vintlabs/ESP32-Zip/README.md

# ESP32-Zip
## ESP32 Development kit with the same form factor (and similar pinout!) to the Raspberry Pi Zero / Zero Wireless
Note: This is not intended to be used with Pi Hats directly, however it is possible that many will work. If you want to try with a Pi Hat, please check the pinouts very carefully!

### Board top:
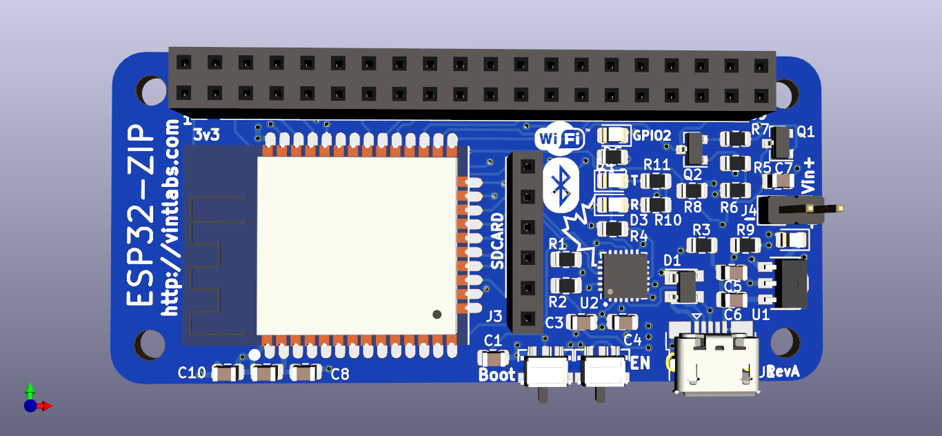
[picture p1: top.png]
Board Top

### Board bottom:
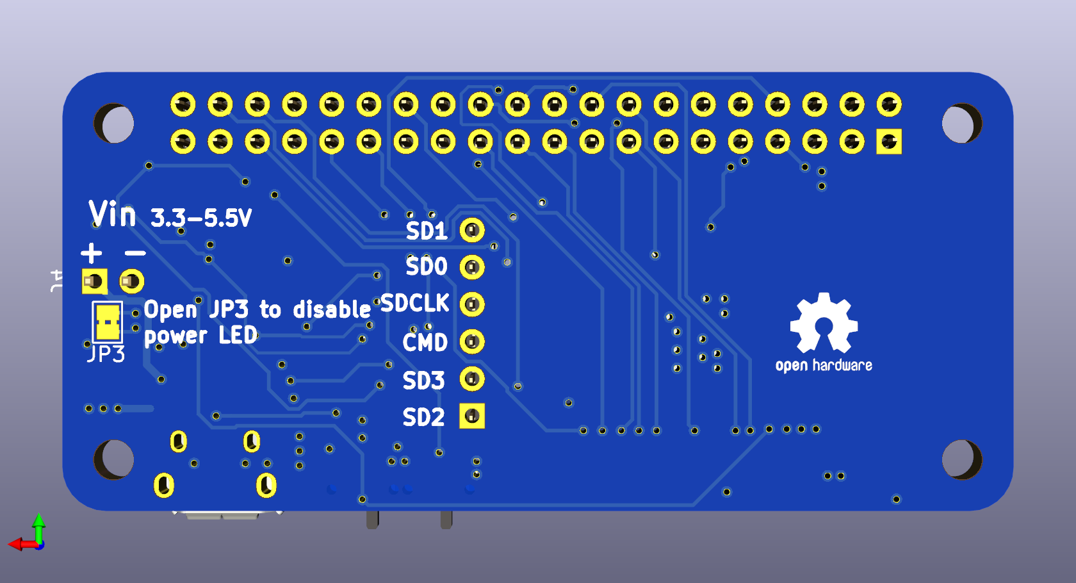
[picture p2: bottom.png]
Board Bottom

### Pinout Diagram:
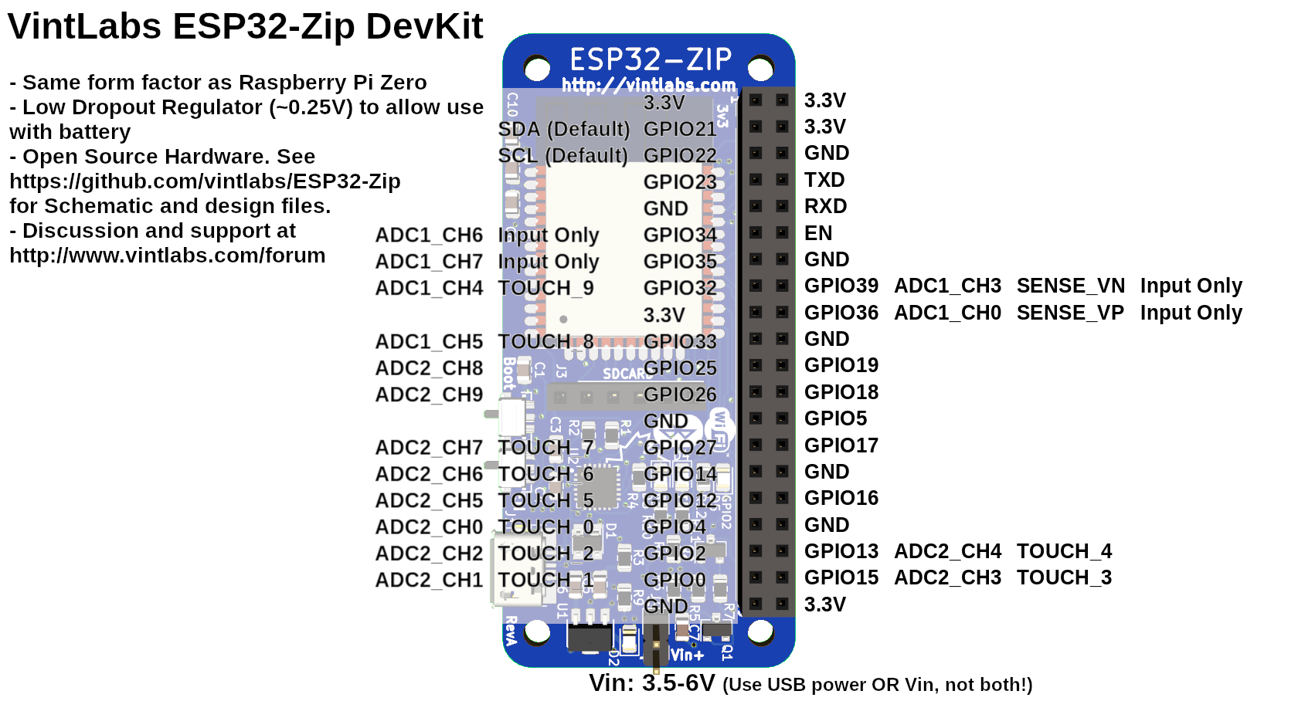
[picture p3: Pinout.png]
Pinout


### The real board:
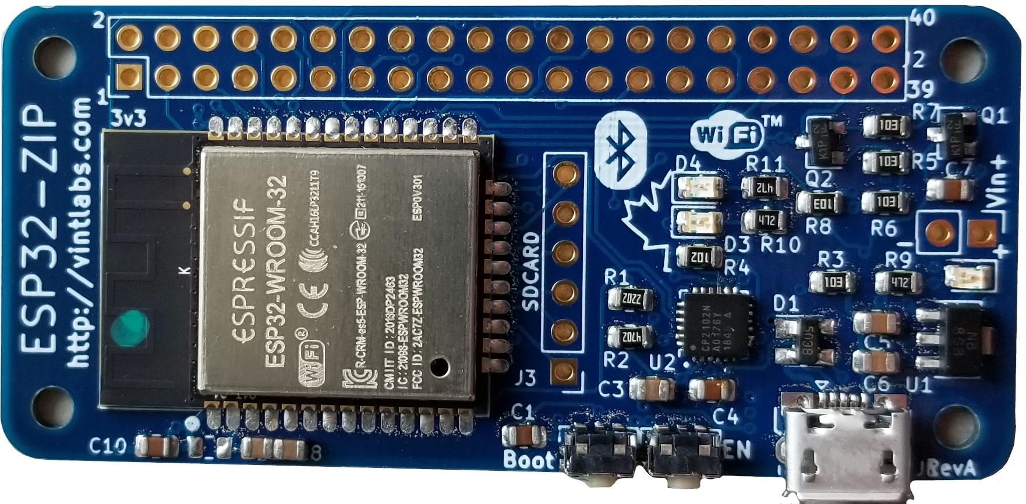
[picture p4: main_image_horizontal.png]
Top
