vintlabs/ESP32-Zip/Pinout.ods

 |  |  | Pin | Pin
 |  | VDD | 1 | 2 | VDD
 | SDA (Default) | GPIO21 | 3 | 4 | VDD
 | SCL (Default) | GPIO22 | 5 | 6 | GND
 |  | GPIO23 | 7 | 8 | TXD
 |  | GND | 9 | 10 | RXD
ADC1_CH6 | Input Only | GPIO34 | 11 | 12 | EN
ADC1_CH7 | Input Only | GPIO35 | 13 | 14 | GND
ADC1_CH4 | TOUCH_9 | GPIO32 | 15 | 16 | GPIO39 | ADC1_CH3 | SENSE_VN | Input Only
 |  | VDD | 17 | 18 | GPIO36 | ADC1_CH0 | SENSE_VP | Input Only
ADC1_CH5 | TOUCH_8 | GPIO33 | 19 | 20 | GND
ADC2_CH8 |  | GPIO25 | 21 | 22 | GPIO19
ADC2_CH9 |  | GPIO26 | 23 | 24 | GPIO18
 |  | GND | 25 | 26 | GPIO5
ADC2_CH7 | TOUCH_7 | GPIO27 | 27 | 28 | GPIO17
ADC2_CH6 | TOUCH_6 | GPIO14 | 29 | 30 | GND
ADC2_CH5 | TOUCH_5 | GPIO12 | 31 | 32 | GPIO16
ADC2_CH0 | TOUCH_0 | GPIO4 | 33 | 34 | GND
ADC2_CH2 | TOUCH_2 | GPIO2 | 35 | 36 | GPIO13 | ADC2_CH4 | TOUCH_4
ADC2_CH1 | TOUCH_1 | GPIO0 | 37 | 38 | GPIO15 | ADC2_CH3 | TOUCH_3
 |  | GND | 39 | 40 | VDD
