vintlabs/ESP32-Zip/ESP32-Zip-BOM.ods

Reference | Quantity | Value | Footprint | Datasheet
C1 C10 C4 C7 | 4 | 0.1u | Capacitor_SMD:C_0805_2012Metric | ~
D1 | 1 | SP0503BAHT | Package_TO_SOT_SMD:SOT-143 | http://www.littelfuse.com/~/media/files/littelfuse/technical%20resources/documents/data%20sheets/sp05xxba.pdf
D2 | 1 | LED RED | LED_SMD:LED_0805_2012Metric | ~
D3 | 1 | LED GREEN | LED_SMD:LED_0805_2012Metric | ~
D4 | 1 | LED YELLOW | LED_SMD:LED_0805_2012Metric | ~
C3 C5 C6 C8 C9 | 5 | 10u | Capacitor_SMD:C_0805_2012Metric | ~
J1 | 1 | USB_B_Micro | 12V-SmartSwitch:USB_Micro-B_Amphenol_10118194-0001LF_Horizontal | ~
Q1 Q2 | 2 | MMBT2222A | Package_TO_SOT_SMD:SOT-23 | http://www.fairchildsemi.com/ds/PN/PN2222A.pdf
R1 | 1 | 22.1k | Resistor_SMD:R_0805_2012Metric | ~
R10 R11 R9 | 3 | 4.7K | Resistor_SMD:R_0805_2012Metric | ~
R2 | 1 | 47.5k | Resistor_SMD:R_0805_2012Metric | ~
R4 | 1 | 1k | Resistor_SMD:R_0805_2012Metric | ~
R3 R5 R6 R7 R8 | 5 | 10k | Resistor_SMD:R_0805_2012Metric | ~
SW1 SW2 | 2 | SW_Push | 12V-SmartSwitch:SW_TACTILE_PO21301
U1 | 1 | AP7215-33YG-13 | ESP32-Zip:AP7215-33YG-13
U2 | 1 | CP2102N-A01-GQFN24 | Package_DFN_QFN:QFN-24-1EP_4x4mm_P0.5mm_EP2.6x2.6mm | http://www.silabs.com/support%20documents/technicaldocs/cp2102n-datasheet.pdf
U3 | 1 | ESP32-WROOM-32 | 12V-SmartSwitch:ESP32-WROOM-32-Espressif-Symbol-Kicad-62379
J2 | 1 | Conn_02x20_Odd_Even | Connector_PinHeader_2.54mm:PinHeader_2x20_P2.54mm_Vertical | ~
J3 | 1 | Conn_01x06_Male | Connector_PinHeader_2.54mm:PinHeader_1x06_P2.54mm_Vertical | ~
J4 | 1 | Conn_01x02_Male | Connector_PinHeader_2.54mm:PinHeader_1x02_P2.54mm_Vertical | ~
JP3 | 1 | SolderJumper_2_Bridged | Jumper:SolderJumper-2_P1.3mm_Bridged2Bar_Pad1.0x1.5mm | ~
