vintlabs/ESP32-Zip/(threads)

Thread 1 (2019-08-28):

Temperature sensor

pvint, 2019-08-28:
Since the board is planned to be in an enclosure it might be nice to have a temperature sensor on the board (to possibly put the device to sleep if temp gets too high as well as for general usage).

Thread 2 (2019-12-05):

Change pin 2 to be 5V

pvint, 2019-12-05:
For better flexibility and compatibility with Pi Zero use VBus (5v from USB) on Pin 2

pvint, 2019-12-15:
Quite difficult to route VBus all the way across the board - not changing at this time. For reference, VBus (+5v) is available on pin 1 of J4

Closed 2019-12-15.

Thread 3 (2019-12-15):

Silkscreen designators for R5 & R7 reversed

pvint, 2019-12-15:
R5 is labelled as R7, and vise-versa

pvint, 2019-12-15:
Fixed in RevB

Closed 2019-12-15.

Thread 4 (2019-12-15):

Serial unreliable (RevA)

pvint, 2019-12-15:
Serial consol sometimes doesn't work until after pressing reset (EN), also often have to hold boot to get into download mode.

Fixed by adding 0.1u cap near pin 3 (EN) of WROOM32 and by removing R7

pvint, 2019-12-15:
Fixed for RevB with 07164f5

Closed 2019-12-15.

Thread 5 (2019-12-15):

Soldering issues on CP2102

pvint, 2019-12-15:
Getting too much solder paste under the ground plane of the chip which makes shorts likely.

pvint, 2019-12-22:
Redeuced size of solder mask under chip for RevB

Closed 2019-12-22.
