vintlabs/ESP32-Zip/(commit log)

2019-08-24 Initial Import
    [ESP32-Zip-B.Cu.gbr, ESP32-Zip-B.Mask.gbr, ESP32-Zip-B.Paste.gbr, ESP32-Zip-B.SilkS.gbr, ESP32-Zip-Edge.Cuts.gbr, ESP32-Zip-F.Cu.gbr, ESP32-Zip-F.Mask.gbr, ESP32-Zip-F.Paste.gbr]
2019-08-26 Fixed missing silk for SD1, added OSHW logo
    [ESP32-Zip-Panelized-B.Cu.gbr, ESP32-Zip-Panelized-B.Mask.gbr, ESP32-Zip-Panelized-B.Paste.gbr, ESP32-Zip-Panelized-B.SilkS.gbr, ESP32-Zip-Panelized-Dwgs.User.gbr, ESP32-Zip-Panelized-Edge.Cuts.gbr, ESP32-Zip-Panelized-F.Cu.gbr, ESP32-Zip-Panelized-F.Mask.gbr]
2019-08-26 Added OSHW logo, added screenies
    [ESP32-Zip.kicad_pcb]
2019-08-26 Added pinout spreadsheet
    [Pinout.ods]
2019-09-03 Added LED on GPIO2
    [ESP32-Zip.kicad_pcb, ESP32-Zip.sch, Pinout.ods]
2019-09-03 Minor silk edits
    [ESP32-Zip.kicad_pcb]
2019-09-03 Silk edits
    [ESP32-Zip.kicad_pcb]
2019-09-03 Set "unlock text orientation" on silk references to prevent flipping when panelizing
    [ESP32-Zip.kicad_pcb]
2019-09-06 Fixed traces too close to edge for V-Groove
    [ESP32-Zip.kicad_pcb, ESP32-Zip.sch]
2019-09-20 Updated gerbers, added pinout diagram
2019-09-20 Adding arduino board definitions
2019-09-22 Update arduino board defs
2019-09-22 update board defs
2019-09-23 update board definition
2019-09-23 updated board defs
2019-09-24 Added ESP32 dependencies to board definition files
2019-09-28 Add BOM
    [ESP32-Zip-BOM.ods]
2019-09-29 Edited order on BOM, minor update to pinout image
    [ESP32-Zip-BOM.ods]
2019-09-29 Added image of RevA board
2019-09-29 Board image
2019-12-15 Added keepout area under antenna
    [ESP32-Zip.kicad_pcb]
2019-12-15 Fix silkscreen for R5 and R7 (#3)
    [ESP32-Zip.kicad_pcb]
2019-12-15 Fix serial issues related to EN/BOOT (#4)
    [ESP32-Zip.kicad_pcb, ESP32-Zip.sch]
2019-12-15 Added extra cap for EN, misc layout improvements
    [ESP32-Zip.kicad_pcb, ESP32-Zip.sch]
2019-12-18 Reduced solder paste under CP2102
    [ESP32-Zip.kicad_pcb]
2019-12-26 Changed shield on USB conn to NC
    [ESP32-Zip.sch]
2020-01-23 Fixed silk designators for R1 R2 (#7)
    [ESP32-Zip.kicad_pcb, ESP32-Zip.sch]
2020-08-15 Removed superflous esp-arduino stuff
